Aj33tSKY/animatronic_raven/wraven/model/Beak.stl

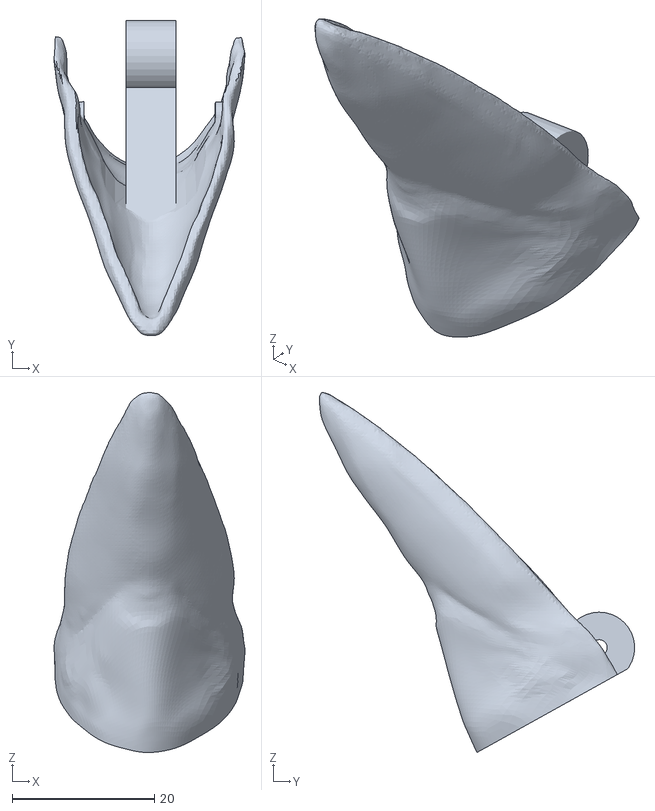
[picture p5: CAD file, 2026-11-10]
wraven/model/Beak.stl
26.9 x 44.4 x 50.7
