Aj33tSKY/animatronic_raven/wraven/model/TailAttachmentTab.stl

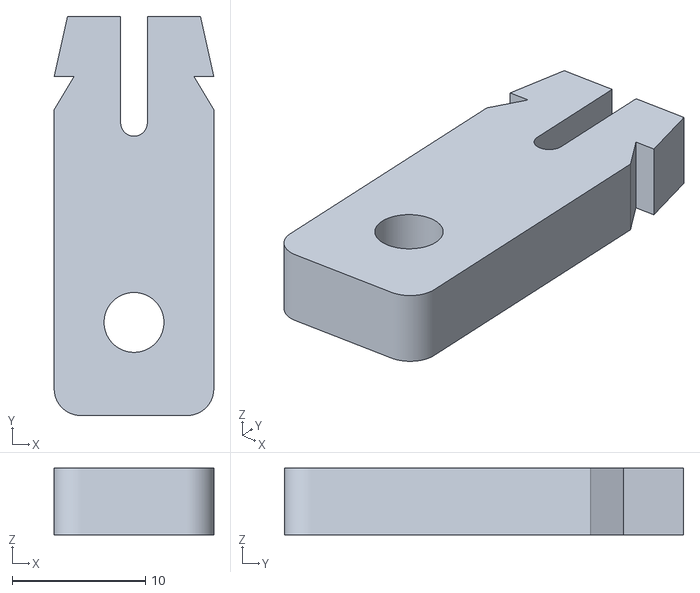
[picture p6: CAD file, 2026-11-10]
wraven/model/TailAttachmentTab.stl
12.0 x 30.0 x 5.00
