Aj33tSKY/animatronic_raven/wraven/model/Body.stl

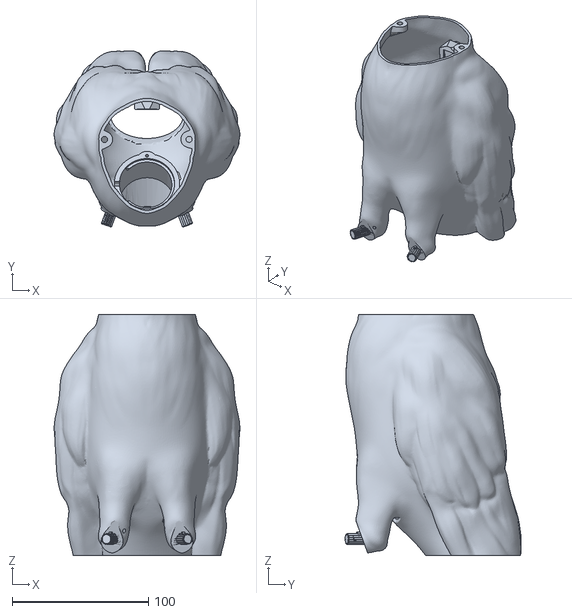
[picture p7: CAD file, 2026-11-10]
wraven/model/Body.stl
136.3 x 129.6 x 177.0
