Aj33tSKY/animatronic_raven/wraven/model/Head.stl

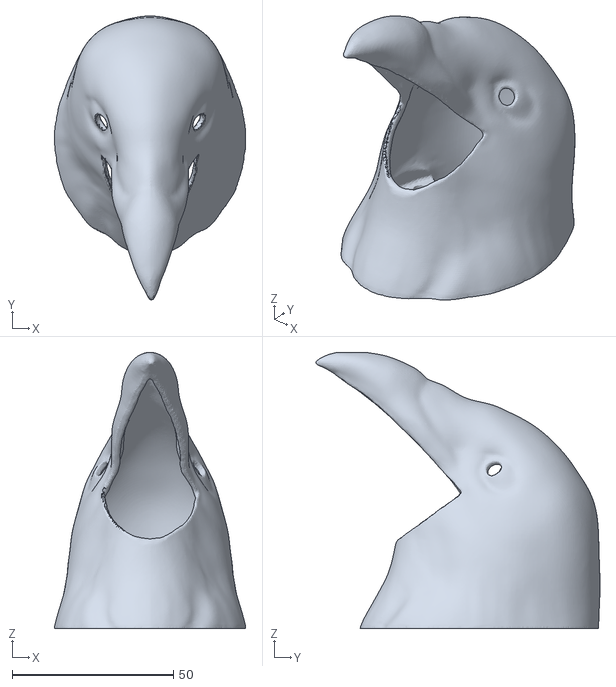
[picture p8: CAD file, 2026-11-10]
wraven/model/Head.stl
59.4 x 88.1 x 85.7
