Aj33tSKY/animatronic_raven/wraven/model/HeadStepperCollar.stl

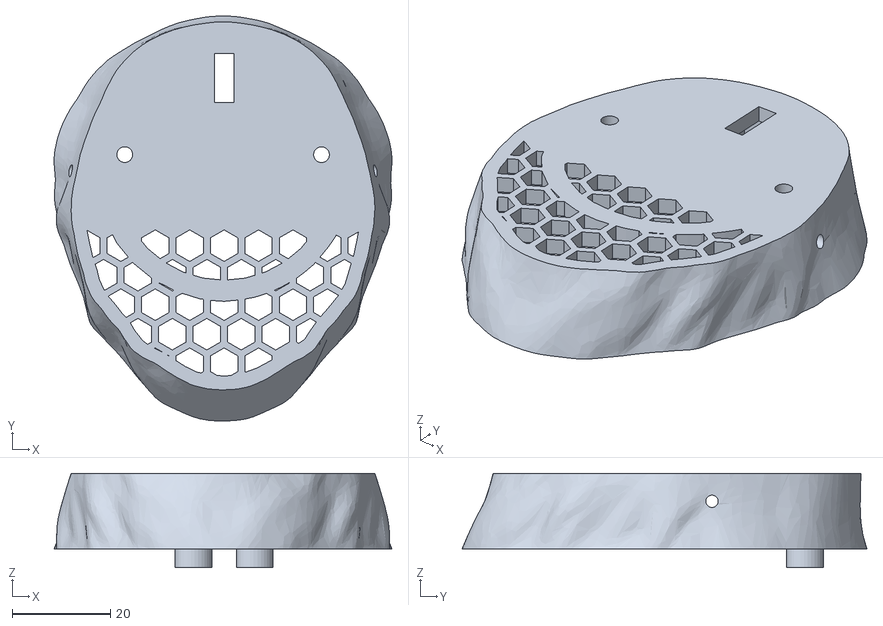
[picture p9: CAD file, 2026-11-10]
wraven/model/HeadStepperCollar.stl
68.7 x 82.3 x 19.2
