Aj33tSKY/animatronic_raven/wraven/model/Feet.stl

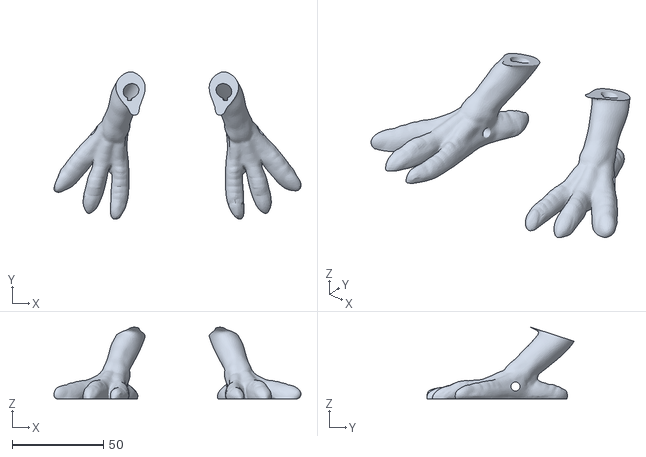
[picture p10: CAD file, 2026-11-10]
wraven/model/Feet.stl
135.7 x 80.9 x 39.3
