Aj33tSKY/animatronic_raven/wraven/model/Actuator.stl

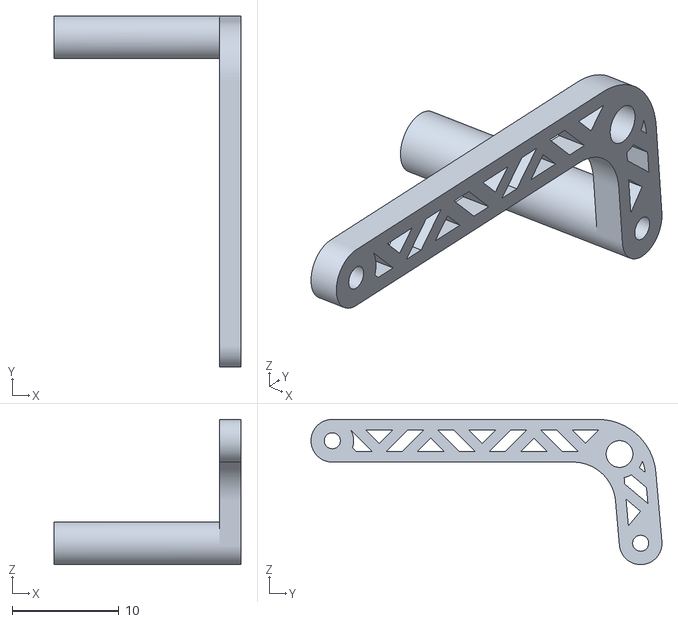
[picture p11: CAD file, 2026-11-10]
wraven/model/Actuator.stl
17.5 x 32.9 x 13.6
