Aj33tSKY/animatronic_raven/wraven/model/Tail.stl

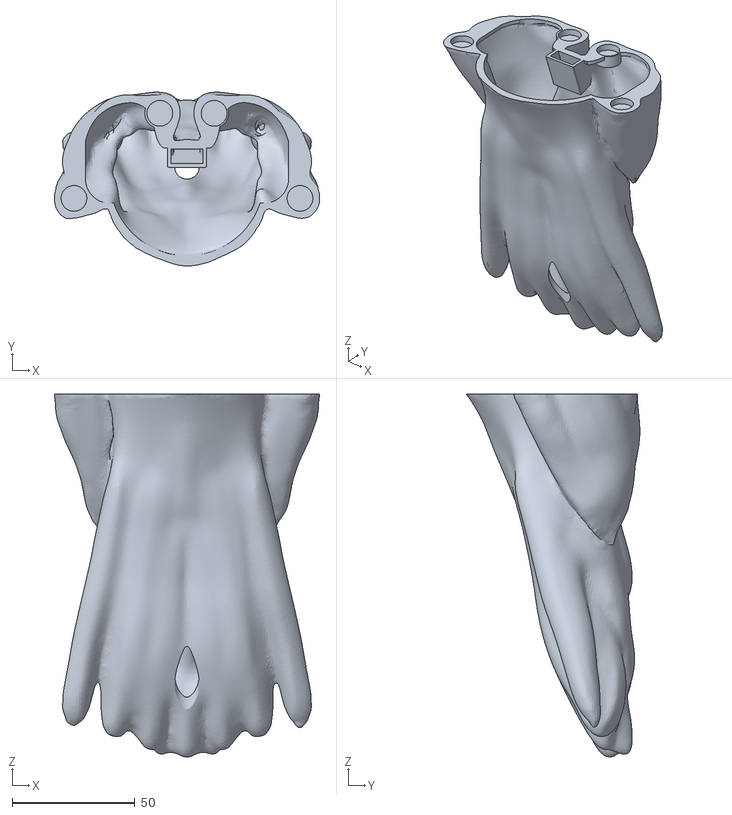
[picture p12: CAD file, 2026-11-10]
wraven/model/Tail.stl
107.9 x 70.7 x 147.7
