Aj33tSKY/animatronic_raven/wraven/model/HeadServoBeakMountPlate.stl

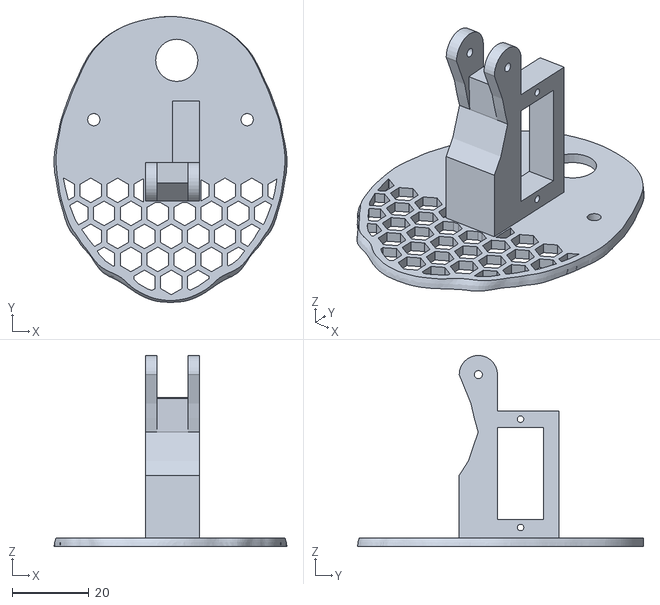
[picture p13: CAD file, 2026-11-10]
wraven/model/HeadServoBeakMountPlate.stl
60.7 x 74.6 x 49.8
