Aj33tSKY/animatronic_raven/wraven/model/ActuatorSpacer.stl

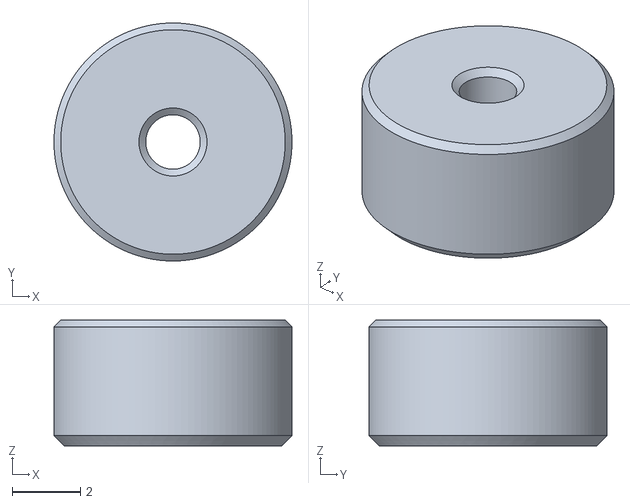
[picture p14: CAD file, 2026-11-10]
wraven/model/ActuatorSpacer.stl
7.00 x 7.00 x 3.70
