Aj33tSKY/animatronic_raven/wraven/model/FeetWithoutHole.stl

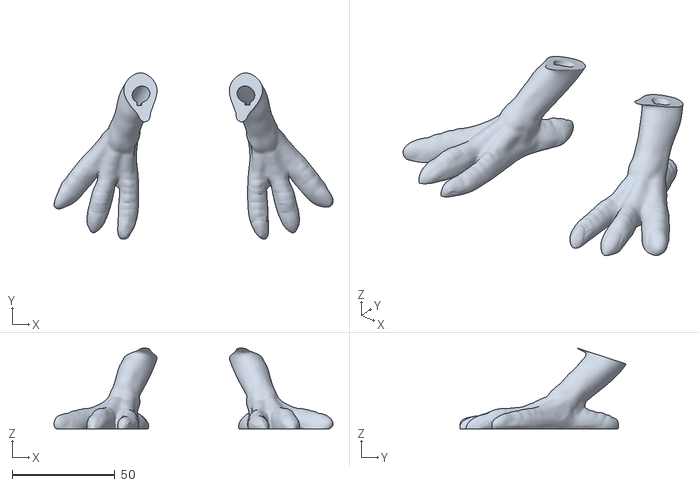
[picture p15: CAD file, 2026-11-10]
wraven/model/FeetWithoutHole.stl
135.7 x 80.9 x 39.3
