Aj33tSKY/animatronic_raven/wraven/model/BodyStepperPlate.stl

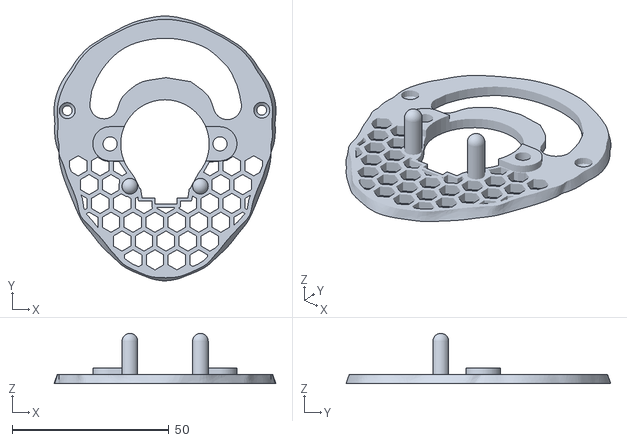
[picture p16: CAD file, 2026-11-10]
wraven/model/BodyStepperPlate.stl
70.8 x 84.5 x 16.0
