Aj33tSKY/animatronic_raven/wraven/model/BodySpeakerFlange.stl

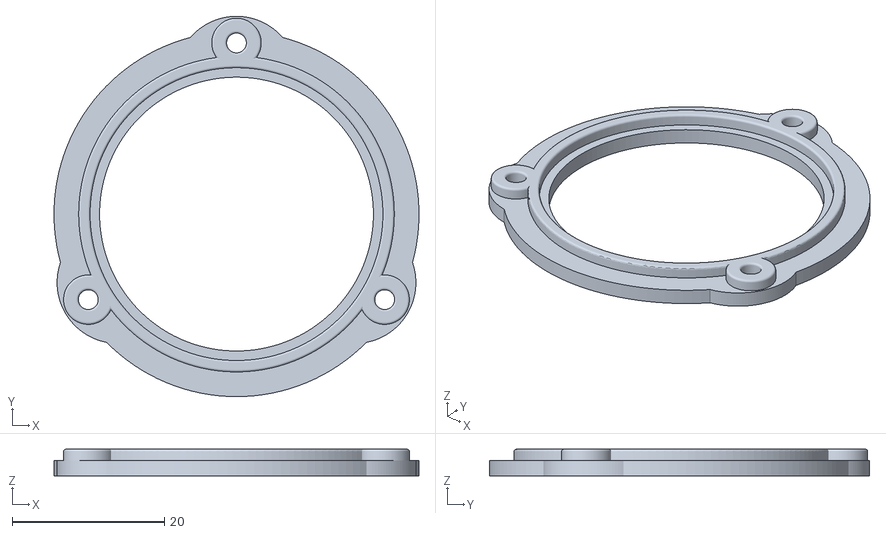
[picture p17: CAD file, 2026-11-10]
wraven/model/BodySpeakerFlange.stl
48.0 x 50.0 x 3.50
