Aj33tSKY/animatronic_raven/(commit log)

2026-11-06 Add voiceCrow: talk to the crow with an AI voice agent
    Replace the DFPlayer/PCB setup with an Arduino Nano on a breadboard and a
    laptop that listens, thinks and speaks through the crow's own speaker:
    - firmware/voice-crow-nano: serial-command firmware for beak servo, neck
    stepper and PWM eyes, calibrated for this crow (open 915, closed 1170)
    - laptop/crow_poly.py: PolyAI Dialog-RSN-1 agent with body-movement tools,
    sentence-by-sentence ElevenLabs speech and lip sync
    - laptop/crow.py: Whisper + Claude version, with shared voice and lip sync
    - Keys load from a git-ignored .env (see .env.example)
    [settings.h]
2026-11-08 Raven: Wren integration, echo cancellation, livelier body and fixes
    Wren (PolyAI's agent builder) as a voice interface:
    - laptop/wren.py: background client for the Wren API (streamed events),
    parsing the real event format (plan, steps, submit_report, complete),
    Wren's own auto-mode decisions, plan/question answers, and one ongoing
    Wren chat per project with same-project requests queued. Raw events are
    logged to laptop/logs/ (git-ignored); `python wren.py` probes one run.
    - Raven drafts each request, reads it back and only sends it after a clear
    confirmation (enforced in code); Wren's news is spoken at a quiet moment.
    - Late "internal" errors after a finished run no longer mark it f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
    [settings.h]
2026-11-09 Restructure into wraven/: prompts, knowledge and tools as files, layered app
    Renames voiceCrow/ to wraven/ and laptop/ to app/, and splits the three big
    files by what you'd want to change:
    - prompts/: Raven's instructions as plain markdown, joined in filename order
    (character, speaking style, games, turn-taking), plus prompts/tools/ for
    the instructions that come with each tool group. <!-- --> notes are stripped.
    - knowledge/: one topic per file, sent as Dialog-RSN-1's poly_knowledge;
    poly_cited_topics is printed when Raven answers from one.
    - tools/: one file per group, each tool's definition beside its code, found
    automatically; _example.py is a template. Groups can switch themsel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
2026-11-10 Protocol fixes, single-project repo, and plain tool lists
    Dialog-RSN-1 protocol (following PolyAI's own client):
    - Tool calls are answered only once their reply is done, and only if it
    completed; a cancelled or failed reply's calls are dropped.
    - A reply's tool results go back together, then one response.create.
    - Nothing else enters the conversation while a tool call is in flight, and
    our own messages wait while the person talks, a reply is open, a create is
    pending, or the server is about to reply.
    - Keepalive (empty session.update after 240 s idle); poly_out_of_domain is
    shown; playback deltas only when more words have been heard.
    Repository:
    - One Wraven project: the 3D model mo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
    [Actuator.stl, ActuatorSpacer.stl, Beak.stl, Body.stl, BodyPCBMount.stl, BodyPIR.stl, BodyPIRMount.stl, BodyPIRPlug.stl]
2026-11-10 Free backup voice, early-interrupt reports, and CUSTOMISE/BOILERPLATE labels
    - Voice: audio/voice.py tries ElevenLabs, then Piper (free, on the laptop,
    ~0.1 s a sentence), then the Mac voice. When ElevenLabs is out of credit
    or refuses the key, it switches to Piper for the rest of the session
    without retrying. Piper loads in the background at start-up.
    integrations/elevenlabs.py now only talks to ElevenLabs.
    - Interrupts: a reply cut off before the first 250 ms playback report, or
    before any of it played, now still gets poly.output_audio.started and
    .stopped, so the server knows what was missed. Audio still in the sound
    card's buffer isn't counted as heard.
    - Labels: every file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
    [body.py]
